ecorov/ecorov.github.io/_posts/2017-08-05-brushless-motor.md

---
layout: post
title: "Tutorial 9: Let RPi control a brushless motor"
date: 2017-08-04 10:32
image: RPiBrushlessMotor_bb.png
---

**Material**: 

 * [Brushless motor](https://www.banggood.com/Wholesale-XXD-A2212-KV1000-Brushless-Motor-H363-For-RC-Airplane-Quadcopter-p-57432.html)
 * [ESC ](https://www.banggood.com/Wholesale-XXD-HW30A-30A-Brushless-Motor-ESC-For-Airplane-Quadcopter-p-50621.html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)
 * [LiPo Battery (3s, 11.1V)](http://www.ebay.com/bhp/3s-lipo-battery)

#### Step 1: connect brushless motor, ESC and RPi as shown below:

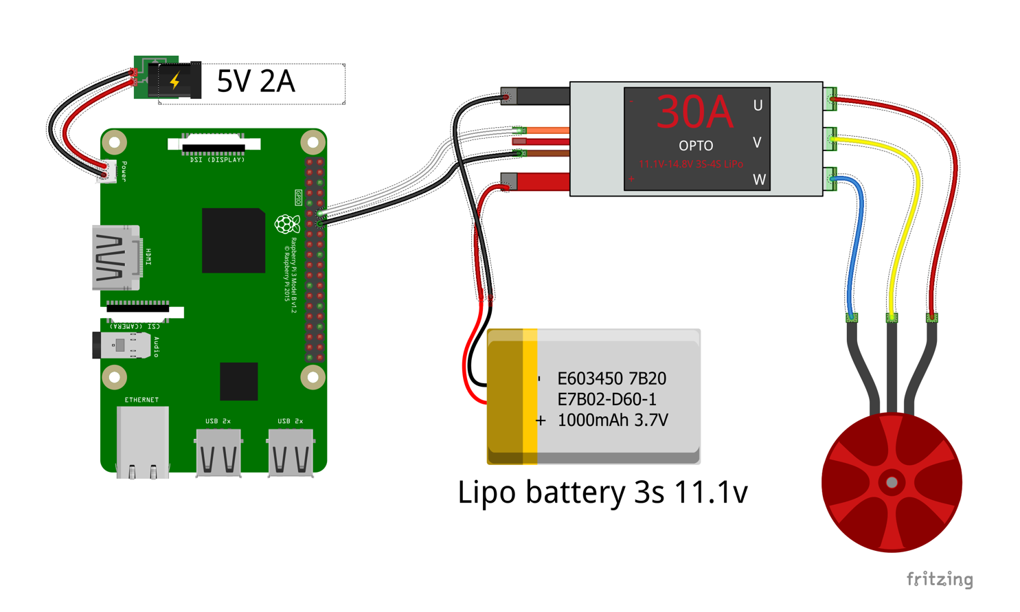
[picture p4: images/RPiBrushlessMotor_bb.png]


Note: normal ESC general has two thick wires (red and black) and 3 thin wires (black, red and white).  The two thick wires supply electricity to brushless motor and ESC. The black thin wire is ground wire which should connect to the GND pin of RPi. The white wire is the control wire which transfer PWM signal from RPi to ESC. The red thin wire is power line supplied from ESC, it generally is 5V, some ESC can supply 2A while most ESC supply 1A current. **Keep in mind: 5V2A power supply from ESC and support power to RPi board using the 5V pin (top right). **

#### Step 2: Install RPIO for RPi 3

RPi 3 has problem to instalL RPIO using `sudo easy_install -U RPIO`, the solution is using the following repository.

~~~
git clone https://github.com/ecorov/RPIO-RPi3.git; 
cd RPIO-RPi3
sudo python setup.py install;
~~~

#### Step 3:  Setup the maximum throttle (2000us) of ESC

**Unconnect one power wire between battery and ESC!!** Then start RPi, open Python console and paste the following code:

~~~

from RPIO import PWM 
PWM.set_loglevel(PWM.LOG_LEVEL_ERRORS) # Hide log info, only show fatal error messages
pwm = PWM.Servo(pulse_incr_us=1)

## Brushless motors
pinPWM = 18

pwm.set_servo(pinPWM, 2000)

~~~

#### Step 4:  Setup the minimum throttle (1000us) of ESC. 

Connect ESC’s power wires to battery. You will hear some sound, like **bee---**, or **bee-bee-**, which means the maximum throttle was setup successfully, and waiting for minimum signal input. Now, back to RPi’s python console, and type the following code quickly (**before you hear any sound of the ESC**):

~~~
pwm.set_servo(pinPWM, 1000)
~~~

This will generate the minimum pwm signal for ESC. If the minimum throttle was successfully setup, you will hear some sound like: **bee---bee-bee-bee 123**. The **bee---** means minimum throttle was setup successfully, **bee-bee-bee** means that ESC detect the battery is a 3s battery, and **123** means that ESC is ready for input.

Now, we can drive the brushless motor using command, e.g.:

~~~
pwm.set_servo(pinPWM, 1050)
~~~

Note: theoretically, the motor should start when the PWM cycle is longer than 1000us, but due to different quality of the motor, some of them will not spin until they receive a higher voltage signal (mine is 1032us). You can start with `pwm.set_servo(pinPWM, 1000)`, and increase with a **5**us to see when your motor will start to spin. If your motor never  spin, anothr reason could be your ESC doesn’t work at all.
