ecorov/ecorov.github.io/_posts/2017-08-07-relay.md

---
layout: post
title: "Tutorial 11: Control LED light through relay"
date: 2017-08-04 10:32
image: relayLed.png
---

**Material**: 

 * **Relay (5v)**
 * **LED light (5v)**
 * **Wires**

#### Step 1: connect resistor to RPi as shown below:

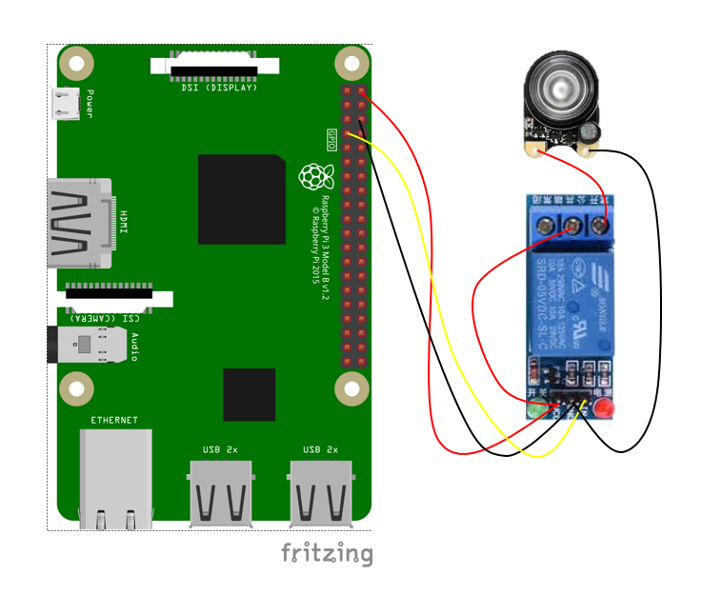
[picture p5: images/relayLed.png]


The power wires from RPi will supply power to both relay and LED light.

#### Step 2:  Start RPi, then open Python console  and paste the following code:

~~~

import time
import RPi.GPIO as GPIO   
GPIO.setmode(GPIO.BCM)

GPIO.setup(4, GPIO.OUT)

for i in range(100):
	GPIO.output(4, GPIO.HIGH)
    time.sleep(1)
	GPIO.output(4, GPIO.LOW)
    time.sleep(1)
~~~

It supposed to see the LED light blink every second.
