ecorov/ecorov.github.io/_posts/2017-08-02-i2c-gy-91.md

---
layout: post
title: "Tutorial 6: Read sensor data using I2C bus: GY-91 (10 DOF IMU)."
date: 2017-08-03 10:32
image: RPiI2C_bb.png
---

**Material**: 

 * [GY-91](https://www.banggood.com/MPU9250BMP280-10DOF-GY-91-Acceleration-Gyroscope-Compass-Nine-Shaft-Sensor-Module-For-Arduino-p-1100982.html)
 * [Jumper wires with double female headers](https://www.itead.cc/1-pin-dual-female-splittable-jumper-wire-200mm-40pcs-pack.html)

**GY-91** contains two sensors: **BMP280** & **MPU9250**.  *BMP280* is the sensor for **temperature & air pressure**, while *MPU9250* contains  3-Axis gyroscope, 3-Axis accelerometer, 3-Axis magnetometer and temperature, so it's also called 10 (9+1) degree of freedom IMU sensor. 

#### Step 1:  enable I2C interface.

Use `sudo raspi-config`  to enable I2C interface: **5 Interfacing Options -> P5 I2C**

Run command `find /dev/*i2c*`, if you can see **/dev/i2c-1**, then we know the I2C interface has been enabled 

#### Step 2:  install i2c-tools to detect connected sensor.

 * **Install i2c-tools using command:** 

~~~
sudo apt-get install -y i2c-tools
~~~

 * **Connect GY-91 to RPi as shown following:**

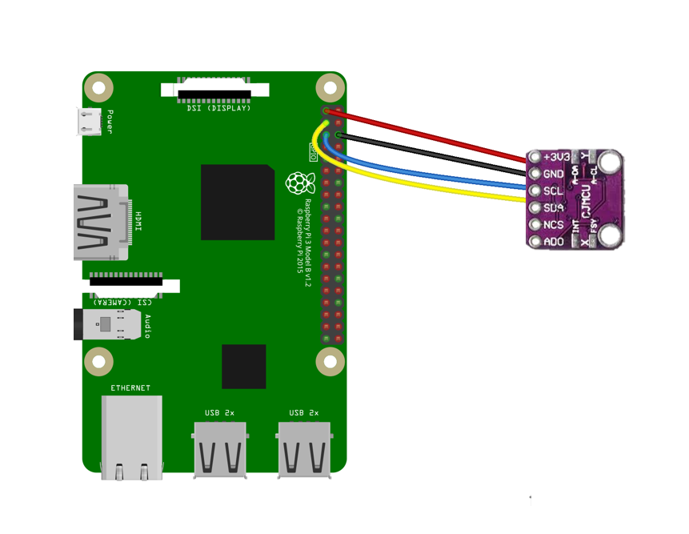
[picture p7: images/RPiI2C_bb.png]


 * **Use the following command to detect the connected sensor. **

~~~
i2cdetect -y 1
~~~

You may get output shown as following: 

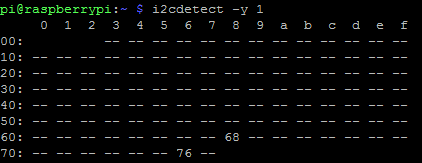
[picture p8: images/i2cmap.png]


**68** is the I2C address for **MPU9250**, and **76** is the I2C address for **BMP280**.

#### Step 3: read sensor data using Python

Let's install python-smbus module (Python) first:

~~~
sudo apt-get install -y python-smbus 
~~~

**a. Read data from BMP280 module** (Copy following code and paste to python)

~~~
#!/usr/bin/python
# -*- coding: utf-8 -*-

# This script is modified based on 
# https://github.com/victorchinn/bmp280/blob/master/bmp280.py
# from S. Dame

import smbus, ctypes     

def getShort(data, index):
  # return two bytes from data as a signed 16-bit value
  return ctypes.c_short((data[index+1] << 8) + data[index]).value

def getUShort(data, index):
  # return two bytes from data as an unsigned 16-bit value
  return (data[index+1] << 8) + data[index]

class BMP280(object):
    # the address of BMP280 module on I2C bus is: 0x76
    def __init__(self):
        self.bus = smbus.SMBus(1)
        self.addr = 0x76
    def readAll(self):
      # Register Addresses
      REG_DATA    = 0xF7
      REG_CONTROL = 0xF4
      REG_CONFIG  = 0xF5
      # Oversample setting - page 27
      OVERSAMPLE_TEMP = 2
      OVERSAMPLE_PRES = 2
      MODE = 1
      # write oversample configuration and mode
      control = OVERSAMPLE_TEMP<<5 | OVERSAMPLE_PRES<<2 | MODE
      self.bus.write_byte_data(self.addr, REG_CONTROL, control)
      # Read blocks of calibration data from EEPROM
      # See Page 22 data sheet
      cal1 = self.bus.read_i2c_block_data(self.addr, 0x88, 24)
      cal2 = self.bus.read_i2c_block_data(self.addr, 0xA1, 1)
      cal3 = self.bus.read_i2c_block_data(self.addr, 0xE1, 7)
      # Convert byte data to word values
      dig_T1 = getUShort(cal1, 0)
      dig_T2 = getShort(cal1, 2)
      dig_T3 = getShort(cal1, 4)
      dig_P1 = getUShort(cal1, 6)
      dig_P2 = getShort(cal1, 8)
      dig_P3 = getShort(cal1, 10)
      dig_P4 = getShort(cal1, 12)
      dig_P5 = getShort(cal1, 14)
      dig_P6 = getShort(cal1, 16)
      dig_P7 = getShort(cal1, 18)
      dig_P8 = getShort(cal1, 20)
      dig_P9 = getShort(cal1, 22)
      data = self.bus.read_i2c_block_data(self.addr, REG_DATA, 6)
      pres_raw = (data[0] << 12) | (data[1] << 4) | (data[2] >> 4)
      temp_raw = (data[3] << 12) | (data[4] << 4) | (data[5] >> 4)
      # Refine temperature based on calibration per spec
      var1 = ((((temp_raw>>3)-(dig_T1<<1)))*(dig_T2)) >> 11
      var2 = (((((temp_raw>>4) - (dig_T1)) * ((temp_raw>>4) - (dig_T1))) >> 12) * (dig_T3)) >> 14
      t_fine = var1+var2
      temperature = float(((t_fine * 5) + 128) >> 8);
      # Refine pressure and adjust for temperature
      var1 = t_fine / 2.0 - 64000.0
      var2 = var1 * var1 * dig_P6 / 32768.0
      var2 = var2 + var1 * dig_P5 * 2.0
      var2 = var2 / 4.0 + dig_P4 * 65536.0
      var1 = (dig_P3 * var1 * var1 / 524288.0 + dig_P2 * var1) / 524288.0
      var1 = (1.0 + var1 / 32768.0) * dig_P1
      if var1 == 0:
        pressure=0
      else:
        pressure = 1048576.0 - pres_raw
        pressure = ((pressure - var2 / 4096.0) * 6250.0) / var1
        var1 = dig_P9 * pressure * pressure / 2147483648.0
        var2 = pressure * dig_P8 / 32768.0
        pressure = pressure + (var1 + var2 + dig_P7) / 16.0
      return temperature/100.0,pressure/100.0

bmp280 = BMP280()

bmp280.readAll()

~~~

**b. Read data from MPU9250 module** (Copy following code and paste to python)

~~~

#!/usr/bin/python
# -*- coding: utf-8 -*-

# This script is modified based on 
# https://github.com/d-zenju/mpu9250/blob/master/MPU9250.py
# from d-zenju

import smbus, time

class MPU9250():
    def __init__(self):
        self.bus = smbus.SMBus(1) 
        self.addr = 0x68 
        # set bypass mode for magnetometer
        self.bus.write_byte_data(self.addr, 0x37, 0x02)        
    def readLine(self, address, high, low):
        hline = self.bus.read_byte_data(address, high)
        lline = self.bus.read_byte_data(address, low)
        value = (hline << 8) + lline        
        if (value >= 0x8000):
            return -((65535 - value) + 1)
        else:
            return value
    def readAccel(self):
        # register address(MPU9250)
        ACCEL_XOUT_H = 0x3B
        ACCEL_XOUT_L = 0x3C
        ACCEL_YOUT_H = 0x3D
        ACCEL_YOUT_L = 0x3E
        ACCEL_ZOUT_H = 0x3F
        ACCEL_ZOUT_L = 0x40
        # calculate
        xout = self.readLine(self.addr, ACCEL_XOUT_H, ACCEL_XOUT_L)
        yout = self.readLine(self.addr, ACCEL_YOUT_H, ACCEL_YOUT_L)
        zout = self.readLine(self.addr, ACCEL_ZOUT_H, ACCEL_ZOUT_L)
        x = 2.0 * xout / 32768.0
        y = 2.0 * yout / 32768.0
        z = 2.0 * zout / 32768.0
        return [x, y, z]
    def readGyro(self):
        # register address(MPU9250)
        GYRO_XOUT_H = 0x43
        GYRO_XOUT_L = 0x44
        GYRO_YOUT_H = 0x45
        GYRO_YOUT_L = 0x46
        GYRO_ZOUT_H = 0x47
        GYRO_ZOUT_L = 0x48
        # calculate
        xout = self.readLine(self.addr, GYRO_XOUT_H, GYRO_XOUT_L)
        yout = self.readLine(self.addr, GYRO_YOUT_H, GYRO_YOUT_L)
        zout = self.readLine(self.addr, GYRO_ZOUT_H, GYRO_ZOUT_L)
        x = 250.0 * xout / 32768.0
        y = 250.0 * yout / 32768.0
        z = 250.0 * zout / 32768.0
        return [x, y, z]
    def readTemp(self):
        # register address(MPU9250)
        TEMP_OUT_H = 0x41
        TEMP_OUT_L = 0x42
        temp_out = self.readLine(self.addr, TEMP_OUT_H, TEMP_OUT_L)
        temp = temp_out / 340.0 + 36.53
        return temp
    def readMagnet(self):    
        # register address(AK8963)
        MAGNET_XOUT_L = 0x03
        MAGNET_XOUT_H = 0x04
        MAGNET_YOUT_L = 0x05
        MAGNET_YOUT_H = 0x06
        MAGNET_ZOUT_L = 0x07
        MAGNET_ZOUT_H = 0x08
        # MPU9250 datsheet page 24: slave address for the AK8963 is 0X0C
        AK8963_ADDRESS = 0x0C
        self.bus.write_byte_data(AK8963_ADDRESS, 0x0A, 0x12)
        time.sleep(0.15)
        # calculate
        xout = self.readLine(AK8963_ADDRESS, MAGNET_XOUT_H, MAGNET_XOUT_L)
        yout = self.readLine(AK8963_ADDRESS, MAGNET_YOUT_H, MAGNET_YOUT_L)
        zout = self.readLine(AK8963_ADDRESS, MAGNET_ZOUT_H, MAGNET_ZOUT_L)
        x = 1200.0 * xout / 4096.0
        y = 1200.0 * yout / 4096.0
        z = 1200.0 * zout / 4096.0
        return [x, y, z]

mpu9250 = MPU9250()

mpu9250.readAccel()
mpu9250.readGyro()
mpu9250.readTemp()
mpu9250.readMagnet()

~~~
