ecorov/ecorov.github.io/_posts/2017-08-03-i2c-ms5803.md

---
layout: post
title: "Tutorial 7: Read sensor data using I2C bus: MS5803 (water depth)."
date: 2017-08-03 10:32
image: MS5803.png
---

**Material**: 

 * [MS5803](http://www.ebay.com/itm/MS5803-14BA-High-Precision-Fluid-Liquid-Gas-Voltage-Sensor-Module-Waterproof-/251857416145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)
 * [Jumper wires with double female headers](https://www.itead.cc/1-pin-dual-female-splittable-jumper-wire-200mm-40pcs-pack.html)

**MS5803** is the unique pressure sensor which allow to detect water detph up to 100 meters. 

#### Step 1: Connect MS5803 to RPi like the "GY-91" in [Tutorial 6](~/2017/08/02/i2c-gy-91.html). 

#### Step 2: Read data from MS5803 module (Copy following code and paste to python)

~~~
import smbus,time,struct

class MS5803:
    osr = {256:0,512:2,1024:4,2048:6,4096:8}
    def __init__(self):
        self.bus = smbus.SMBus(1)
        self.addr = 0x76
        self.reset()
        time.sleep(0.05)
        self._C = self.read_prom()
    def __enter__(self):
        return self
    def __exit__(self,*ignored):
        return True
    def reset(self):
        self.bus.write_byte(self.addr,0x1E)
        time.sleep(0.1)
    def read(self,osr=4096):
        D1 = self.raw_pressure(osr=osr)
        D2 = self.raw_temperature(osr=osr)
        C = self._C
        dT = D2 - C[5]*(2**8)
        TEMP = 2000L + dT*C[6]/(2**23)
        OFF = long(C[2])*(2**16) + (long(C[4])*dT)/(2**7)
        SENS = long(C[1])*(2**15) + (long(C[3])*dT)/(2**8)
        if TEMP < 2000:
            T2 = 3*(dT**2)/2**33
            OFF2 = 3*((TEMP - 2000)**2)/2
            SENS2 = 5*((TEMP - 2000)**2)/(2**3) # 2**3 == readability...
            if TEMP < -1500:
                OFF2 = OFF2 + 7*((TEMP + 1500)**2)
                SENS2 = SENS2 + 4*((TEMP + 1500)**2)
        else:
            T2 = 7*(dT**2)/2**37
            OFF2 = ((TEMP-2000)**2)/(2**4)
            SENS2 = 0
        TEMP = TEMP - T2
        OFF = OFF - OFF2
        SENS = SENS - SENS2
        P = (long(D1)*SENS/(2**21) - OFF)/(2**15)
        TEMP = TEMP/100.
        P = P/10.
        return {'mbar':P,'temp':TEMP}
    def pretty(self,r=None):
        if r is None:
            r = self.read()
        return '{} kPa, {} Deg.C'.format(r['mbar'],r['temp'])
    def read_prom(self):
        tmp = [self.bus.read_byte_data(self.addr,i) for i in range(0xA0,0xAE+1)]
        C = struct.unpack('>HHHHHHHB',''.join([chr(c) for c in tmp]))
        return C
    def raw_pressure(self,osr=4096):
        self.bus.write_byte(self.addr,0x40 + self.osr[osr])
        time.sleep(0.1)
        tmp = self.bus.read_i2c_block_data(self.addr,0,3)
        tmp.insert(0,0)
        D1 = struct.unpack('>I',''.join([chr(c) for c in tmp]))[0]
        return D1
    def raw_temperature(self,osr=4096):
        self.bus.write_byte(self.addr,0x50 + self.osr[osr])
        time.sleep(0.1)
        tmp = self.bus.read_i2c_block_data(self.addr,0,3)
        tmp.insert(0,0)
        D2 = struct.unpack('>I',''.join([chr(c) for c in tmp]))[0]
        return D2

MS5803().read()
~~~

#### Note! The default I2C address for MS5803 module is **0x76**, which happens to be the address of **BMP280** in Tutorial 6. If you connect both two modules to RPi, we will get problem of reading sensor data for both of them. Luckily, we can change the address of **MS5803** to **0x77** (remember to update the line **self.addr = 0x76** in above block.) by soldering together two pins on board (shown as below).

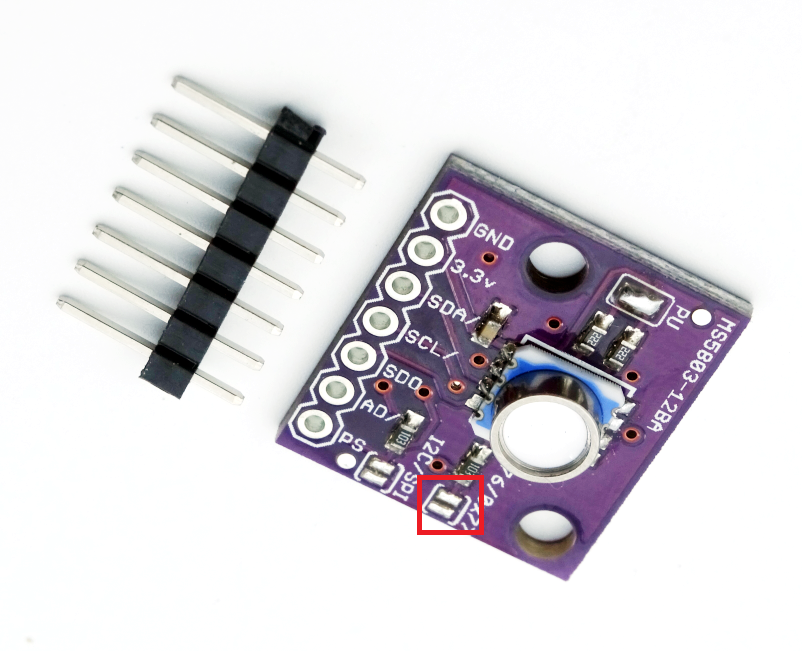
[picture p9: images/MS5803.png]
