ecorov/ecorov.github.io/css/screenshot-ecorov.png

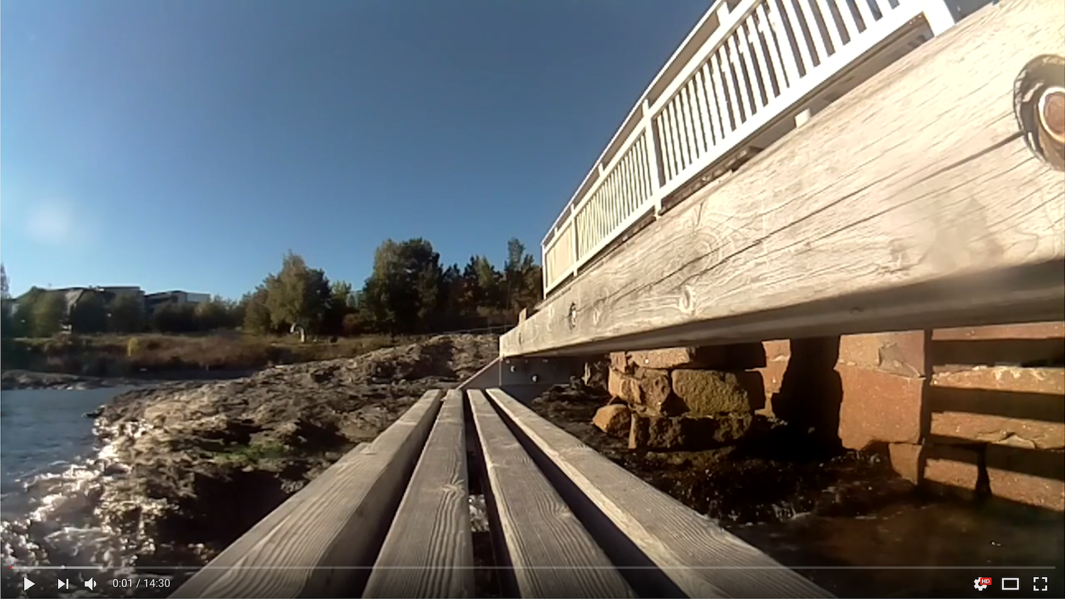
css/screenshot-ecorov.png
