ecorov/ecorov.github.io/images/backgroud.png

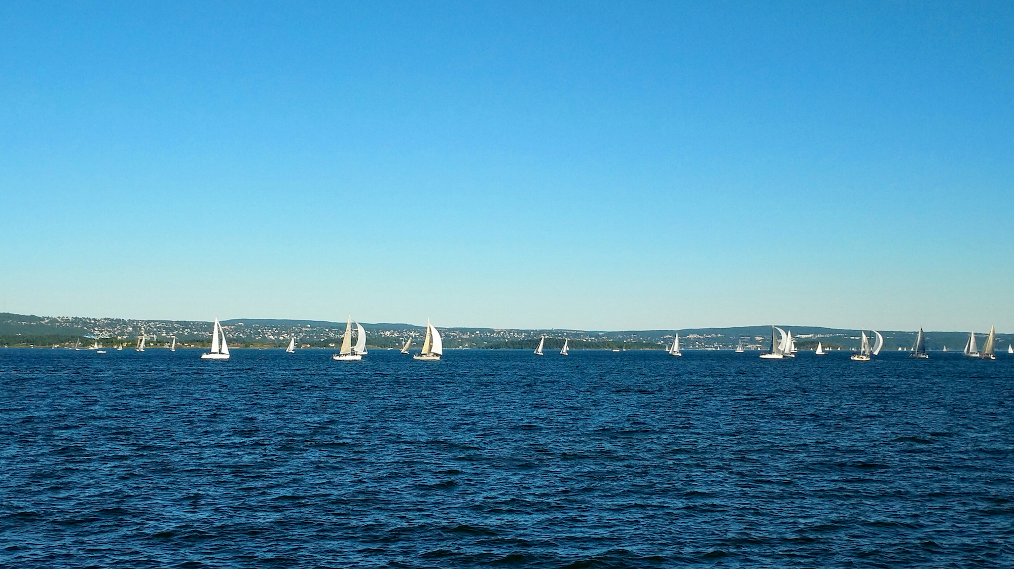
images/backgroud.png
