ecorov/ecorov.github.io/images/ecoBoat.jpg

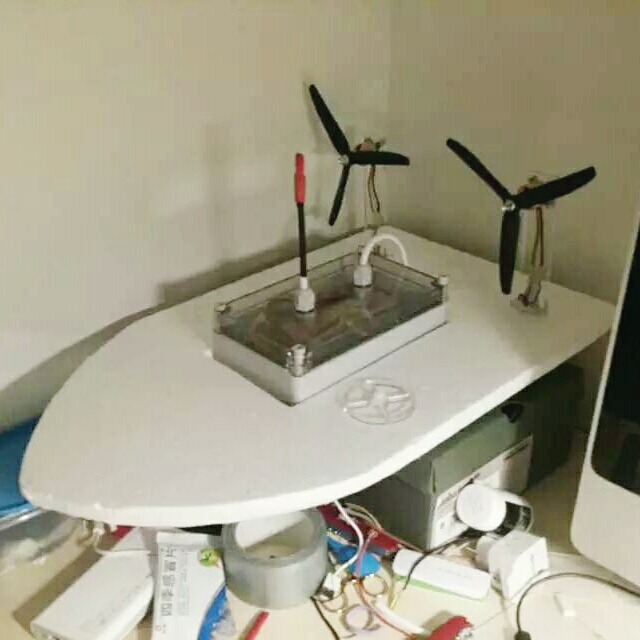
images/ecoBoat.jpg
