ecorov/ecorov.github.io/images/im.png

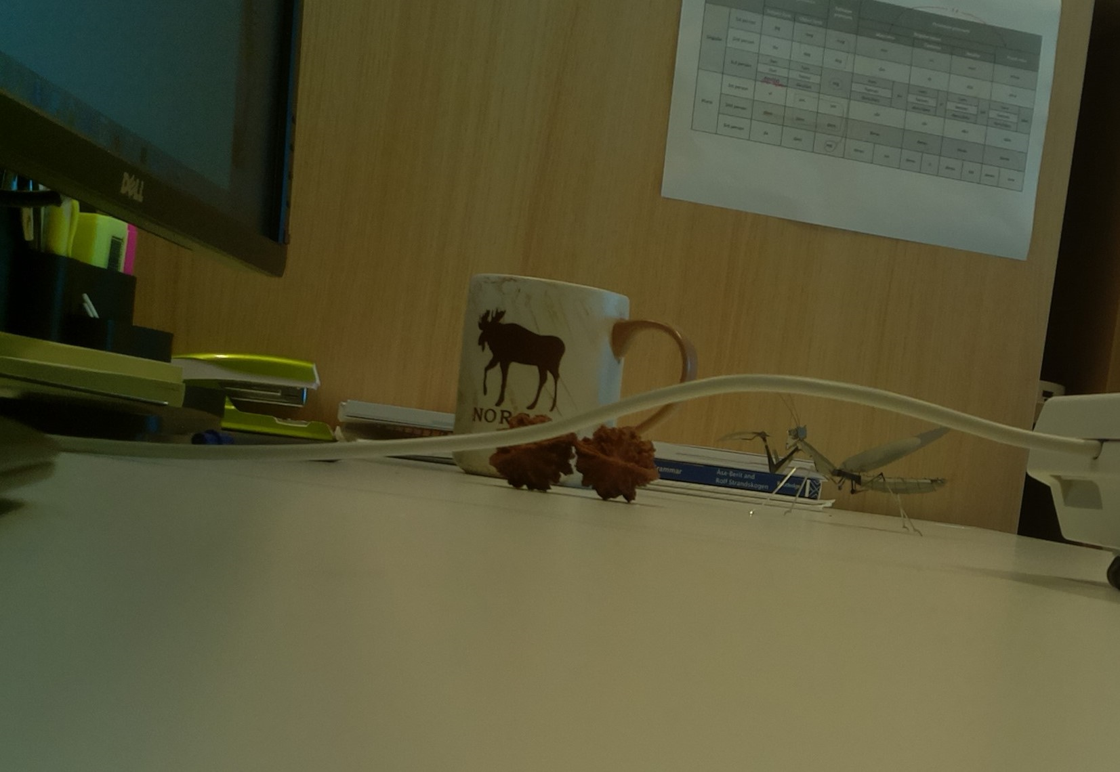
images/im.png
