ecorov/ecorov.github.io/images/keyfingerprint.PNG

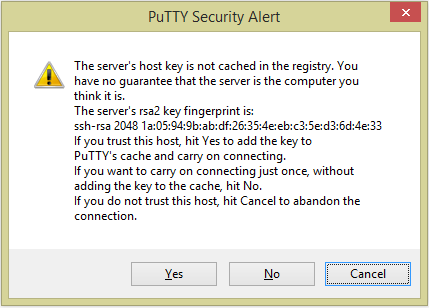
images/keyfingerprint.PNG
