ecorov/ecorov.github.io/images/logged.PNG

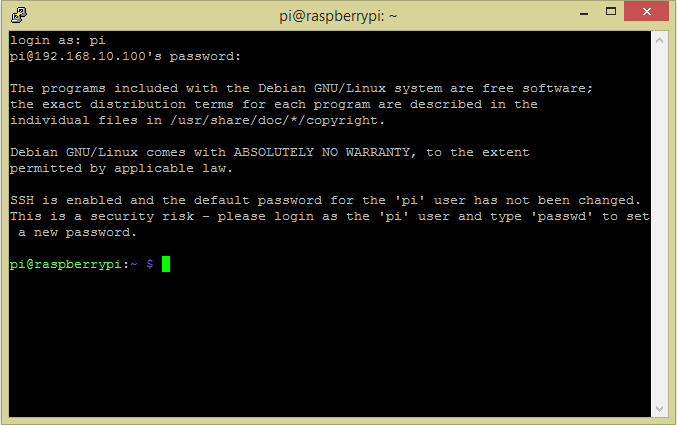
images/logged.PNG
