ecorov/ecorov.github.io/images/myROV.jpg

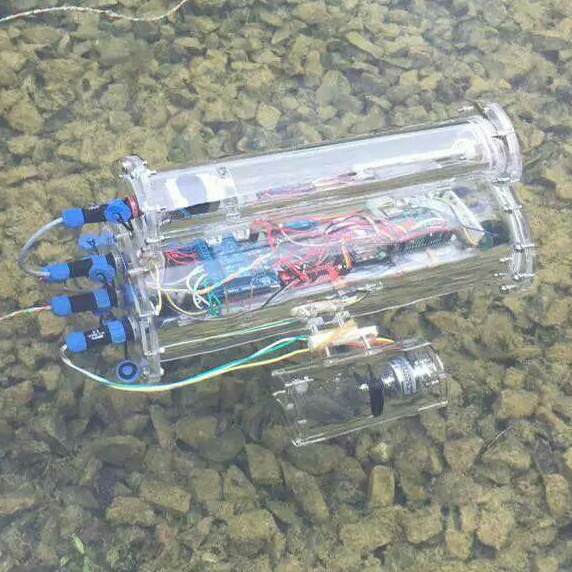
images/myROV.jpg
