ecorov/ecorov.github.io/images/preview-python.png

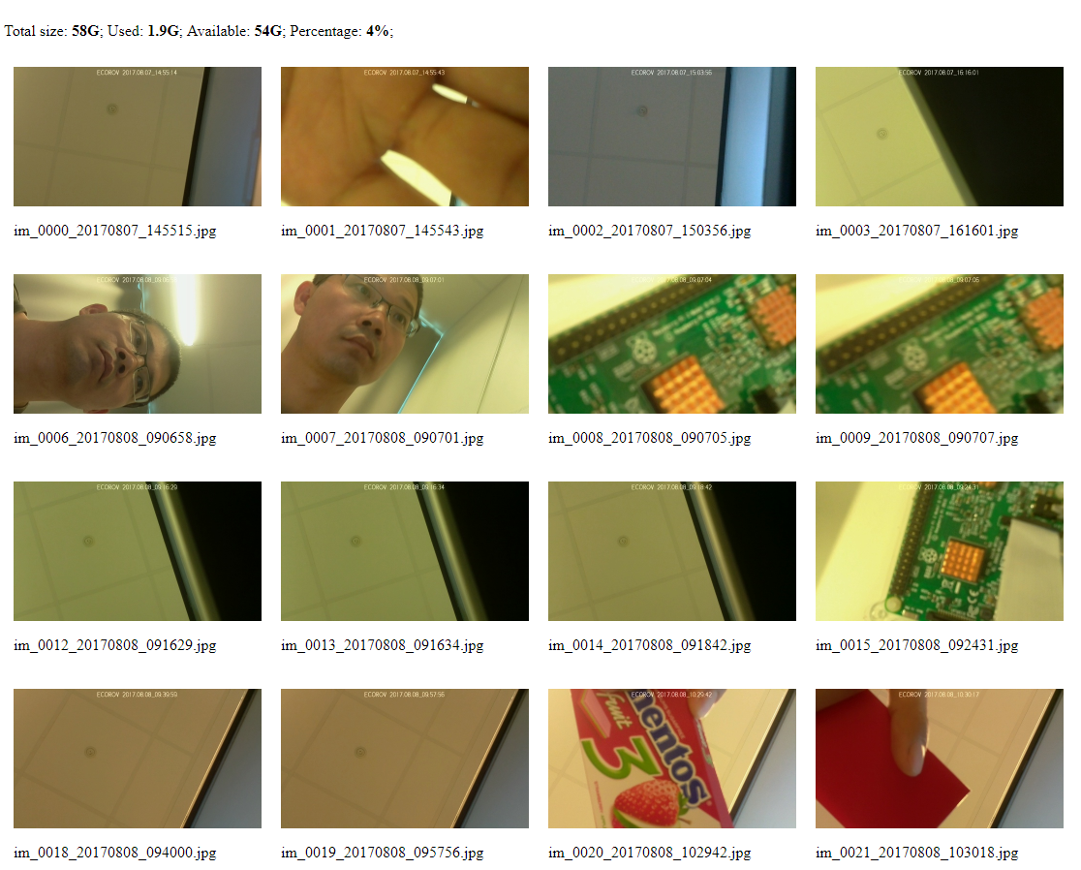
images/preview-python.png
