ecorov/ecorov.github.io/images/webCtrl.png

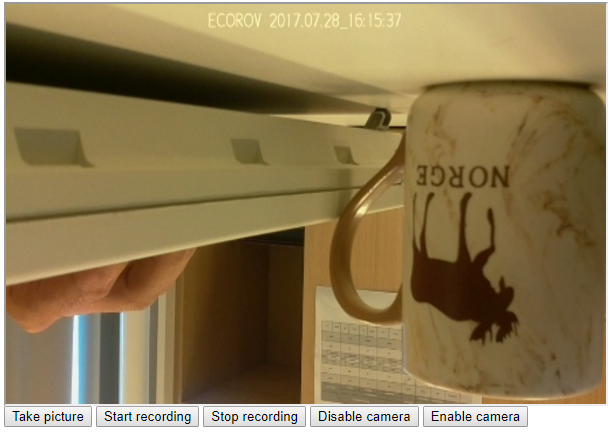
images/webCtrl.png
