ecorov/ecorov.github.io/(list of files, drawings)

Other design files:
images/all.fzz
images/RPiBrushlessMotor.fzz
images/RPiI2C.fzz
images/RPiStepMotor.fzz
images/watersensor.fzz
