ecorov/ecorov.github.io/(commit log)

2017-08-03 Tutorial 6
    [RPiBrushlessMotor.fzz, RPiI2C.fzz, RPiStepMotor.fzz]
2017-08-04 Tutorial 10
    [watersensor.fzz]
2017-08-07 Tutorial 12
    [all.fzz]
2019-08-01 Update 2017-08-08-wiring-diagram - Copy.md
